dbond762/FPGA-Coursework-Sound_Level_Indicator/README.md

# Індикатор рівня звуку

Модуль визначає гучність звукового сигналу за останніми відліками й видає її у вигляді рівня від 0 до 8, придатного для керування стовпчиком світлодіодів.

## Регістри

Зсув | Назва | Доступ        | Значення
-----|-------|---------------|---------
0x00 | IN    | запис         | Вхідний відлік, [15:0], знакове число. Запис запускає один крок.
0x04 | N     | запис/читання | Розмір вікна, 1–8.
0x08 | PEAK  | читання       | Поточний пік, ціле без знака.
0x0C | LEVEL | читання       | Поточний рівень, розряди [3:0], значення 0–8.

## Архітектура

Дизайн поділено на два модулі: обчислювальне ядро і AXI4-Lite обгортку з регістрами. Ядро нічого не знає про шину, тому його можна перевірити окремо простим тестбенчем, а обгортка відповідає тільки за протокол і регістри.

### Ядро `level_indicator`

Файл `ip_repo/axi_level_indicator/level_indicator.sv`.

| Порт | Напрям | Опис |
|---|---|---|
| `clk`, `reset` | вхід | Тактовий сигнал і асинхронне скидання (активний рівень 1) |
| `in_data[15:0]` | вхід | Знаковий відлік |
| `in_valid` | вхід | Імпульс на один такт: прийняти `in_data` як новий відлік |
| `window[3:0]` | вхід | Розмір вікна N |
| `peak[15:0]` | вихід | Пік, ціле без знака |
| `level[3:0]` | вихід | Рівень 0–8 |

Як працює:

1. **Модуль на вході.** Модуль відліку обчислюється комбінаційно, у 16-бітній беззнаковій арифметиці: `in_data[15] ? (~in_data + 1) : in_data`. Для −32768 це дає `0x8000` = 32768, що вміщується в 16 біт без знака.
2. **Зсувний регістр на 8 елементів** (максимальне вікно). На кожен `in_valid` модуль нового відліку записується в `mem[0]`, решта зсувається, тож `mem[0]` завжди найновіший відлік. Усі тригери працюють від одного `clk`, а `in_valid` діє як clock enable.
3. **Маска вікна.** Маска `win_mask[7:0]` обчислюється з N і зберігається в регістрі (для N = 3 це `00000111`), а елементи поза маскою замінюються нулем. Модулі невід'ємні, тому нуль не впливає на максимум. `mem[0]` у вікні завжди, тому N = 0 поводиться як N = 1. Буфер завжди зберігає останні 8 відліків, тому при зменшенні N враховуються лише останні N, а при збільшенні старі відліки знову потрапляють у вікно.
4. **Дерево порівнянь і регістр піку.** Максимум 8 значень обчислюється комбінаційно деревом із 7 компараторів глибиною 3 (8 → 4 → 2 → 1), а результат записується в регістр `peak` на кожному такті.
5. **Рівень.** ⌈PEAK / 4096⌉ обчислюється комбінаційно від регістра `peak` як `peak[15:12] + (|peak[11:0])`: старші 4 біти плюс 1, якщо молодші 12 біт не нульові. Це те саме, що `(peak + 4095) >> 12`, але замість 17-бітного суматора потрібен 4-бітний інкремент. Оскільки `peak` ≤ `0x8000`, результат 0–8 вміщується в 4 біти.

**Затримка.** Запис відліку оновлює буфер на першому фронті, а `peak` і `level` — на наступному, тобто через один такт. Зміна N відображається через два такти: спочатку оновлюється регістр маски, потім `peak`. Процесор читає `PEAK` через кілька тактів після запису, тому цієї затримки не помічає.

**Чому пік зареєстровано.** У першій версії `peak` і `level` були повністю комбінаційними. Тоді на 100 МГц шлях `n_reg` → маска → дерево порівнянь → суматор рівня → мультиплексор читання AXI → `s_axi_rdata` мав 15 рівнів логіки і 12,6 нс при бюджеті 10 нс (WNS = −2,69 нс). Регістр `peak` розрізає цей шлях на два коротші, а спрощена формула рівня скорочує другий. Після цього залишився шлях `n_reg` → маска → дерево → `peak` (WNS = −0,85 нс), тому маску теж винесено в регістр: порівняння `i < N` більше не стоїть на початку довгого шляху.

### AXI-обгортка `axi_level_indicator`

Файл `ip_repo/axi_level_indicator/axi_level_indicator.sv`. AXI4-Lite slave з 32-бітною шиною даних і 4-бітною адресою. Порти шини мають префікс `s_axi_`, тому IP Packager у Vivado сам розпізнає інтерфейс.

- **Запис.** Канали адреси (AW) і даних (W) приймаються незалежно і в будь-якому порядку. Коли отримано обидва і канал відповіді вільний, виконується запис і видається відповідь `OKAY`.
- **IN (`0x00`).** Запис формує для ядра імпульс `in_valid` на один такт; молодші 16 біт даних ідуть у `in_data`. Тому кожен запис — це рівно один відлік, навіть якщо значення повторюється. Читання повертає 0.
- **N (`0x04`).** Записується, тільки якщо значення в діапазоні 1–8; запис іншого значення ігнорується і N зберігає попереднє значення. Після скидання N = 1.
- **PEAK (`0x08`), LEVEL (`0x0C`).** Тільки читання, значення беруться напряму з виходів ядра. Запис ігнорується.
- **Скидання.** `s_axi_aresetn` (активний рівень 0) інвертується і подається на ядро.
- **Порт `level[3:0]`** виведено назовні окремо від шини для підключення світлодіодів через XDC.

## Веріфікація

Є два тестбенчі, обидва перевіряють результат самі: кожна перевірка друкує `PASS` або `FAIL`, а в кінці виводиться `ALL TESTS PASSED` або кількість невдалих перевірок.

| Тестбенч | Що перевіряє |
|---|---|
| `coursework.srcs/sim_1/new/tb_level_indicator.sv` | Ядро `level_indicator` напряму: сценарії 1–3 і додаткові перевірки нижче |
| `coursework.srcs/sim_1/new/tb_axi_level_indicator.sv` | AXI-обгортку: ті самі сценарії 1–3 через шину. Перед кожним сценарієм скидання, запис `N` у `0x04` і читання назад. Після кожного запису в `IN` читаються `PEAK` і `LEVEL` і додатково звіряється зовнішній порт `level` |

### Як отримано очікувані значення

Очікувані значення обчислено вручну до запуску за такими правилами:

1. **Модуль відліку**: |x|. Для −32768 модуль дорівнює 32768, тобто на 1 більший за найбільше додатне значення 32767.
2. **Пік**: найбільший модуль серед останніх N відліків. Відліки, що вийшли з вікна, не враховуються.
3. **Рівень**: діапазон 0…32768 поділено на 8 рівних сходинок по 32768 / 8 = 4096. Рівень дорівнює ⌈PEAK / 4096⌉, в апаратурі це `(PEAK + 4095) >> 12`. Нульовий сигнал дає рівень 0, будь-який ненульовий — щонайменше 1, а 32767 і 32768 — рівень 8. Межі сходинок: 4096·k дає рівень k, а 4096·k + 1 — рівень k + 1.

У таблицях вікно записано від найстарішого відліку до найновішого, у вигляді модулів.

### Сценарій 1 — ковзне вікно, N = 4

Перевіряє, що старі відліки виходять із вікна і пік зменшується.

| № | IN | Вікно (модулі) | PEAK | LEVEL | Пояснення |
|---|---:|---|---:|---:|---|
| 1 | 100 | 100 | 100 | 1 | Перший відлік |
| 2 | −300 | 100, 300 | 300 | 1 | Від'ємний відлік, береться модуль |
| 3 | 50 | 100, 300, 50 | 300 | 1 | |
| 4 | 20 | 100, 300, 50, 20 | 300 | 1 | Вікно заповнене |
| 5 | 10 | 300, 50, 20, 10 | 300 | 1 | 100 вийшов з вікна |
| 6 | 5 | 50, 20, 10, 5 | 50 | 1 | 300 вийшов з вікна, пік зменшився |

### Сценарій 2 — граничні значення, N = 1

Граничний випадок: найбільше додатне значення і −32768, модуль якого не вміщується в 16-бітне знакове число.

| № | IN | Вікно (модулі) | PEAK | LEVEL | Пояснення |
|---|---:|---|---:|---:|---|
| 1 | 32767 | 32767 | 32767 | 8 | ⌈32767 / 4096⌉ = ⌈7,9998⌉ = 8 |
| 2 | −32768 | 32768 | 32768 | 8 | Модуль 32768 = `0x8000`, максимально можливий сигнал |

### Сценарій 3 — рівні та знак, N = 3

| № | IN | Вікно (модулі) | PEAK | LEVEL | Пояснення |
|---|---:|---|---:|---:|---|
| 1 | 0 | 0 | 0 | 0 | Нульовий сигнал дає рівень 0 |
| 2 | 16384 | 0, 16384 | 16384 | 4 | 16384 = 4·4096 рівно, межа сходинки |
| 3 | 32767 | 0, 16384, 32767 | 32767 | 8 | |
| 4 | 16384 | 16384, 32767, 16384 | 32767 | 8 | |
| 5 | 0 | 32767, 16384, 0 | 32767 | 8 | Вікно заповнене, 32767 ще в ньому |
| 6 | −16384 | 16384, 0, 16384 | 16384 | 4 | 32767 вийшов з вікна |
| 7 | −32768 | 0, 16384, 32768 | 32768 | 8 | |

### Додаткові перевірки ядра

Ці сценарії є тільки в тестбенчі ядра.

| Сценарій | Дії | Очікуваний результат | Пояснення |
|---|---|---|---|
| Межі рівнів (N = 1) | Відліки 0, 1, 4096·k і 4096·k + 1 для k = 1…7, 32767, −32768, −1, −4097, −28673 | 0 → 0; 4096·k → k; 4096·k + 1 → k + 1; 32767 і −32768 → 8; −1 → 1; −4097 → 2; −28673 → 8 | Обидві сторони кожної межі сходинки |
| Помилкове N = 0 | N = 0, відліки 100, 200 | PEAK = 100, потім 200; LEVEL = 1 | Помилковий випадок: ядро трактує N = 0 як N = 1 (наймолодший відлік завжди у вікні) |
| N = 1 | N = 1, відліки 100, 200 | PEAK = 100, потім 200; LEVEL = 1 | Пік дорівнює останньому відліку |
| Зміна N | N = 8, відліки 30000 і 7 × 10; потім N = 3 і N = 8 без нових записів | Після записів PEAK = 30000, LEVEL = 8; при N = 3 PEAK = 10, LEVEL = 1; при N = 8 знову PEAK = 30000, LEVEL = 8 | При зменшенні N враховуються тільки останні N відліків, старі значення в буфері не губляться |
| Повторний запис | N = 2, відліки 500, 100, 100 | PEAK = 500, 500, 100 | Два однакові відліки — це два окремі кроки |
| Без запису | N = 1, відлік 200, далі `in_data` = 30000 три такти при `in_valid` = 0 | PEAK = 200, LEVEL = 1 | Без імпульсу запису буфер не змінюється |

### Перевірка тестбенчів на модулі з помилкою

Щоб показати, що тестбенчі справді щось перевіряють, є копія ядра з навмисною помилкою: `coursework.srcs/sim_1/new/level_indicator_bug.sv`. Модуль у ній має ту саму назву `level_indicator`, тому в проєкті одночасно вмикається тільки один із двох файлів. Копію додано в проєкт як design source (як і оригінал), а перемикання робиться в Sources: правою кнопкою → Disable File / Enable File. Після перевірки оригінал вмикається назад, а копія вимикається. Під час запуску копія друкує `*** BUGGY level_indicator (registered abs_in) ***`.

**Помилка.** Модуль відліку `abs_in` зроблено регістром і записано неблокуючим присвоюванням у тому самому такті, що й зсув буфера:

```systemverilog
abs_in <= in_data[15] ? (~in_data + 16'd1) : in_data;
mem    <= {mem[6:0], abs_in};   // у буфер іде старе abs_in
```

Обидва присвоювання неблокуючі, тому в буфер потрапляє модуль **попереднього** відліку: буфер відстає від входу на один запис, а після скидання першим у буфер іде 0. Саме цю помилку було допущено в першій версії ядра.

**Очікувані провали в сценаріях 1–3.** Для моделі з помилкою вміст буфера зсунуто на один відлік. Перевірка падає там, де через це змінюється PEAK або LEVEL.

| Сценарій | № | IN | Очікувано PEAK / LEVEL | З помилкою PEAK / LEVEL | Результат |
|---|---|---:|---|---|---|
| 1 (N = 4) | 1 | 100 | 100 / 1 | 0 / 0 | FAIL |
| | 2 | −300 | 300 / 1 | 100 / 1 | FAIL |
| | 3–5 | 50, 20, 10 | 300 / 1 | 300 / 1 | PASS |
| | 6 | 5 | 50 / 1 | 300 / 1 | FAIL |
| 2 (N = 1) | 1 | 32767 | 32767 / 8 | 0 / 0 | FAIL |
| | 2 | −32768 | 32768 / 8 | 32767 / 8 | FAIL |
| 3 (N = 3) | 1 | 0 | 0 / 0 | 0 / 0 | PASS |
| | 2 | 16384 | 16384 / 4 | 0 / 0 | FAIL |
| | 3 | 32767 | 32767 / 8 | 16384 / 4 | FAIL |
| | 4–5 | 16384, 0 | 32767 / 8 | 32767 / 8 | PASS |
| | 6 | −16384 | 16384 / 4 | 32767 / 8 | FAIL |
| | 7 | −32768 | 32768 / 8 | 16384 / 4 | FAIL |

Частина кроків проходить, бо при широкому вікні зсув на один відлік не змінює максимум. Тому важливі сценарії з N = 1 і з виходом піку з вікна: на них помилка видна на кожному кроці.

**Очікуваний підсумок:**

- `tb_axi_level_indicator`: 9 із 15 перевірок відліків падають (3 + 2 + 4), у кінці `9 CHECK(S) FAILED`. Читання N назад проходить, бо регістр N у обгортці не залежить від помилки.
- `tb_level_indicator`: 38 із 55 перевірок падають, у кінці `38 CHECK(S) FAILED`. Окрім сценаріїв 1–3, падають майже всі межі рівнів (20 із 21, проходить тільки перший відлік 0), N = 0 і N = 1, повторний запис і перевірка без запису (там пік 0 замість 200, бо 200 ще не дійшло до буфера). У зміні N падає тільки перший запис, а перевірки при N = 3 і N = 8 проходять: після восьми записів зсув на один відлік уже не впливає.

### Результати

Усі перевірки в обох тестбенчах пройшли (`ALL TESTS PASSED`).

**Рис. 1.** Тестбенч ядра `tb_level_indicator`

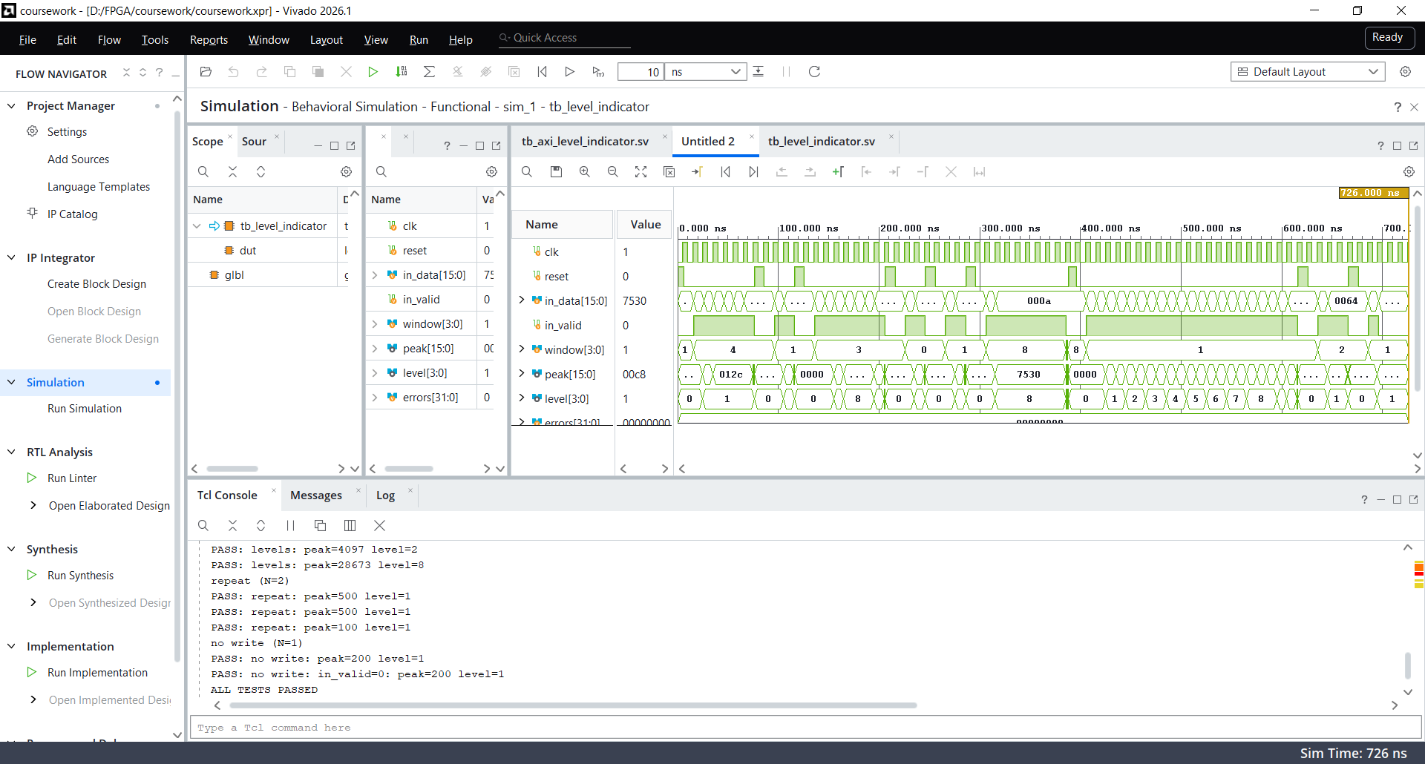
[picture p1: docs/Figure 1 - Core Testbench.png]
Рис. 1 - Тестбенч ядра


**Рис. 2.** Тестбенч AXI-обгортки `tb_axi_level_indicator`

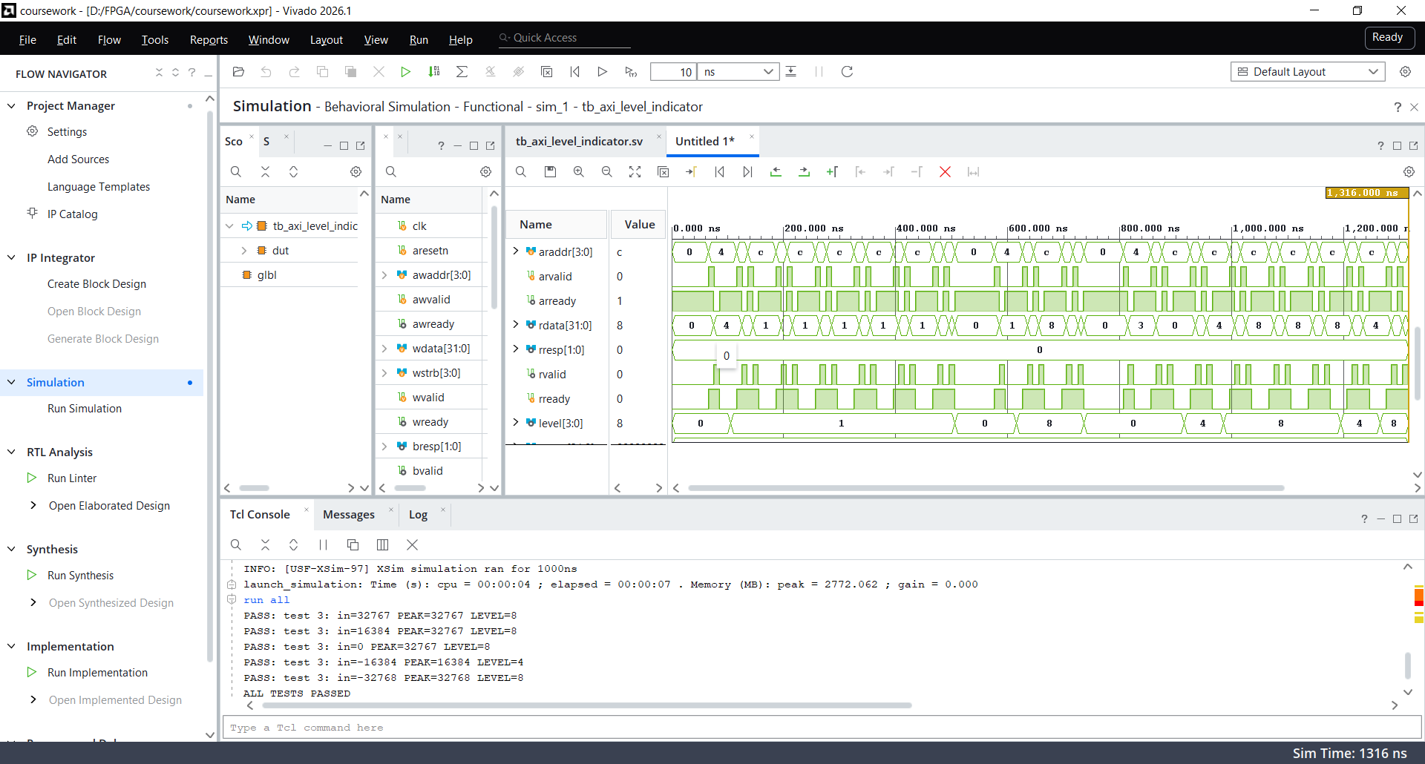
[picture p2: docs/Figure 2 - AXI wrapper Testbench.png]
Рис. 2 - Тестбенч AXI обгортки


**Перевірка на модулі з помилкою.** Результати збіглися з передбаченими: `tb_level_indicator` завершився з `38 CHECK(S) FAILED`, `tb_axi_level_indicator` — з `9 CHECK(S) FAILED`. Отже, тестбенчі виявляють помилку в ядрі.

**Рис. 3.** Тестбенч ядра `tb_level_indicator` на модулі з помилкою

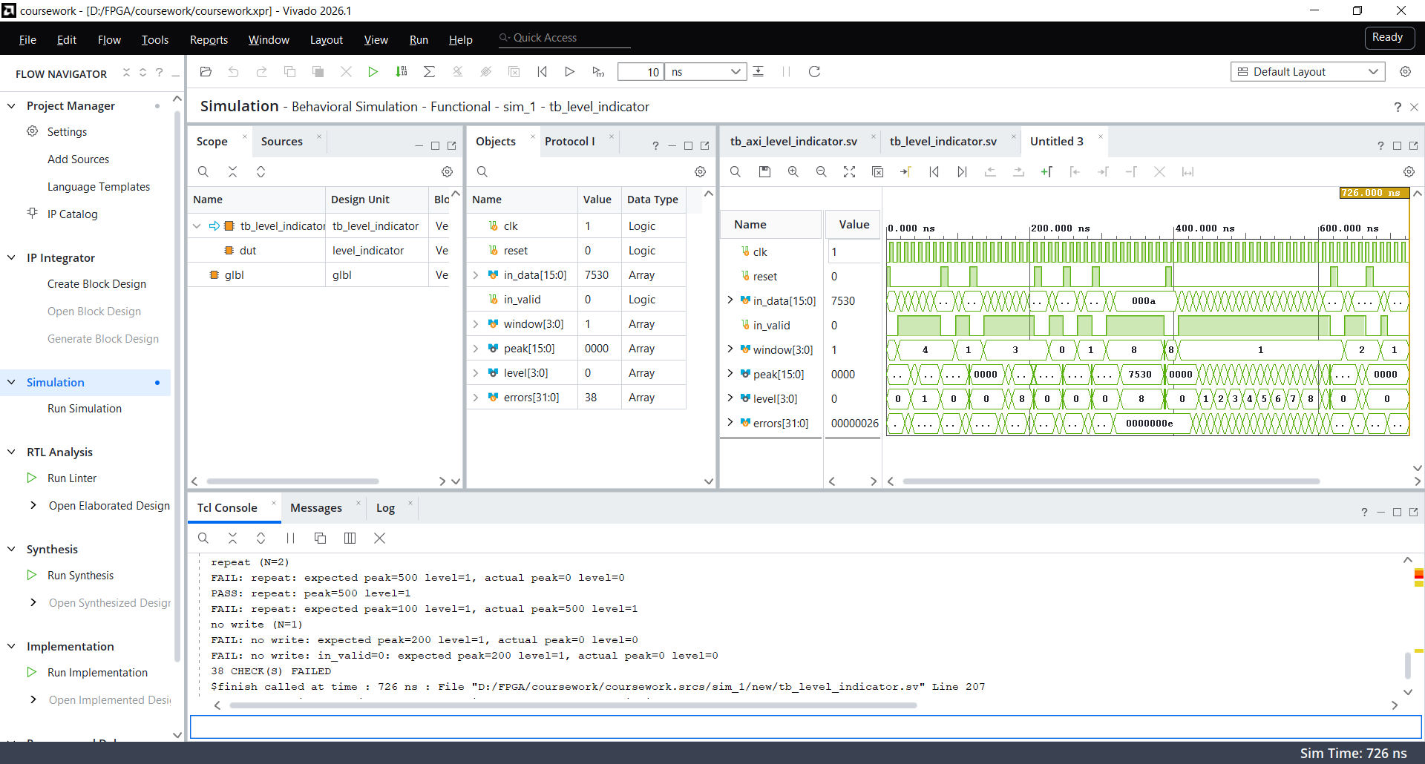
[picture p3: docs/Figure 3 - Core Testbench with bug.png]
Рис. 3 - Тестбенч ядра з помилкою


**Рис. 4.** Тестбенч AXI-обгортки `tb_axi_level_indicator` на модулі з помилкою

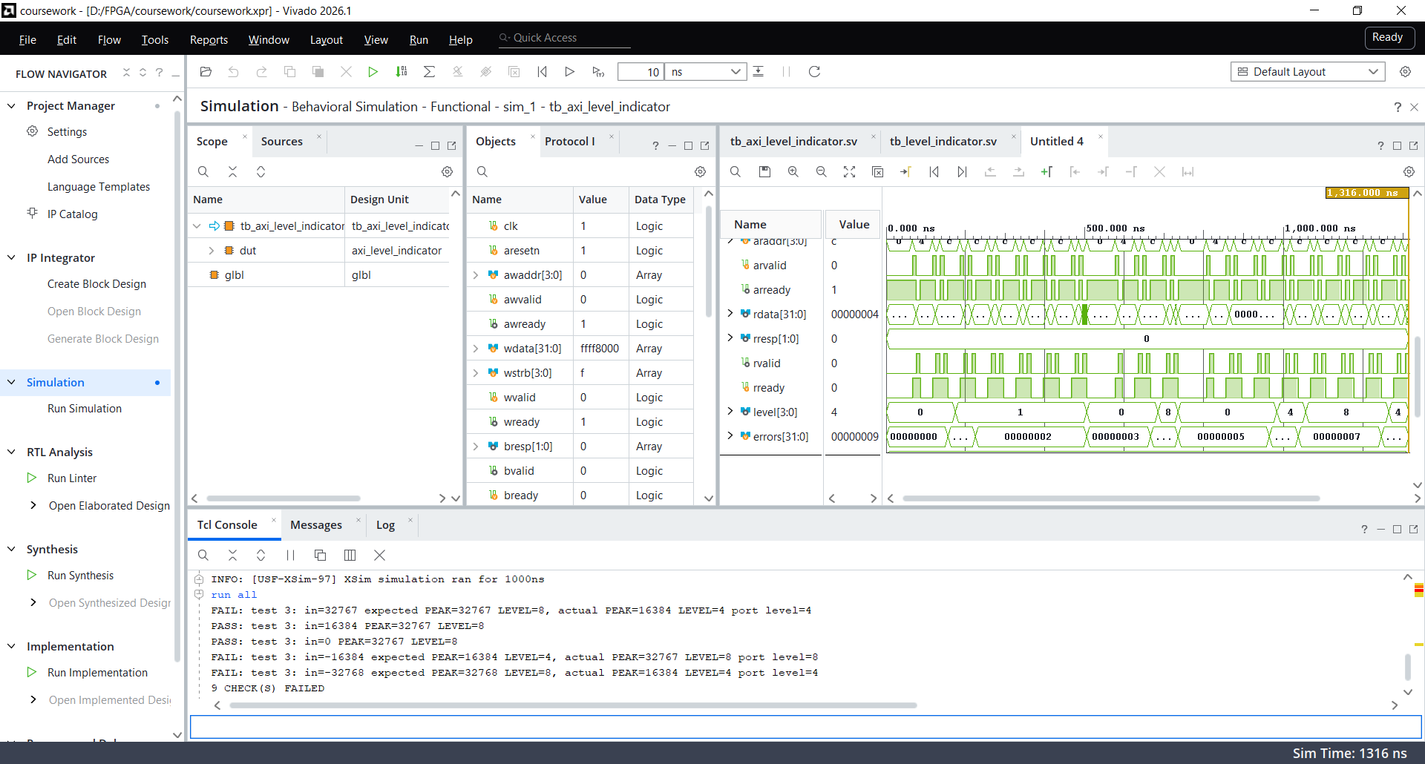
[picture p4: docs/Figure 4 - AXI wrapper Testbench with bug.png]
Рис. 4 - Тестбенч AXI обгортки з помилкою


## IP Catalog

Модуль було упаковано в IP block та додано в IP Catalog (Рис. 5).

**Рис. 5.** Модуль AXI Level Indicator в IP Catalog

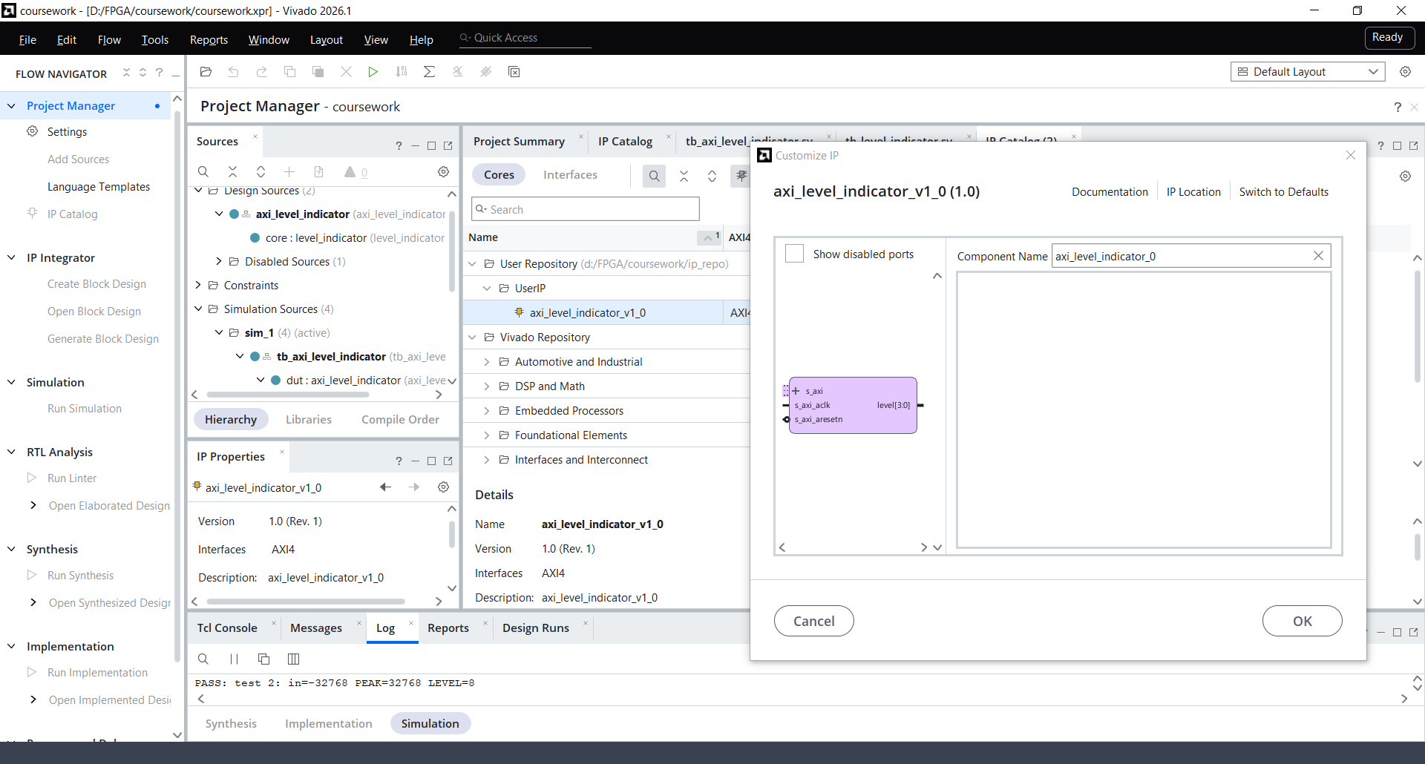
[picture p5: docs/Figure 5 - AXI Level Indicator in IP Catalog.png]
Рис. 5 - Модуль AXI Level Indicator в IP Catalog


## Block Design

Система будується на базі MicroBlaze процесора, до якого по AXI шині під'єднаний наш IP block AXI Level Indicator.

**Рис. 6.** Block Design

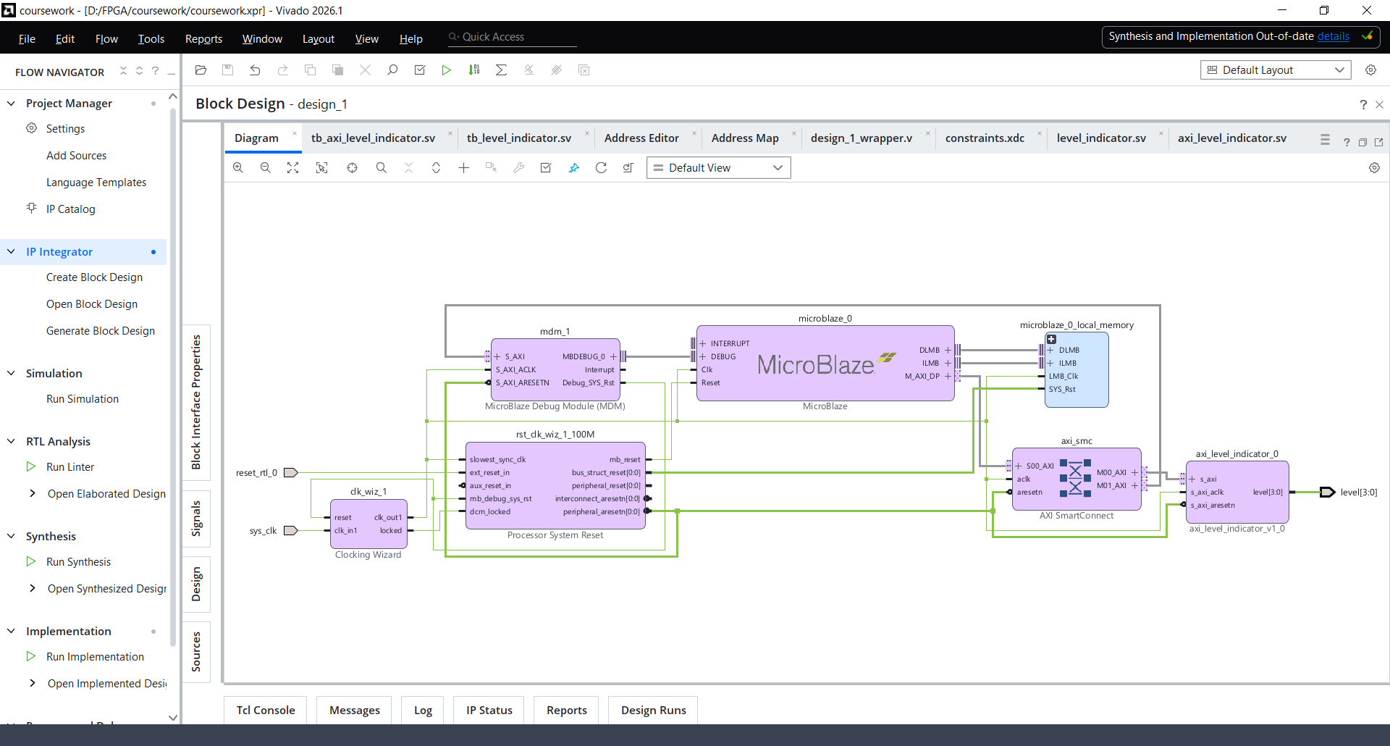
[picture p6: docs/Figure 6 - Block Design.png]
Рис. 6 - Block Design


**Рис. 7.** Address Editor

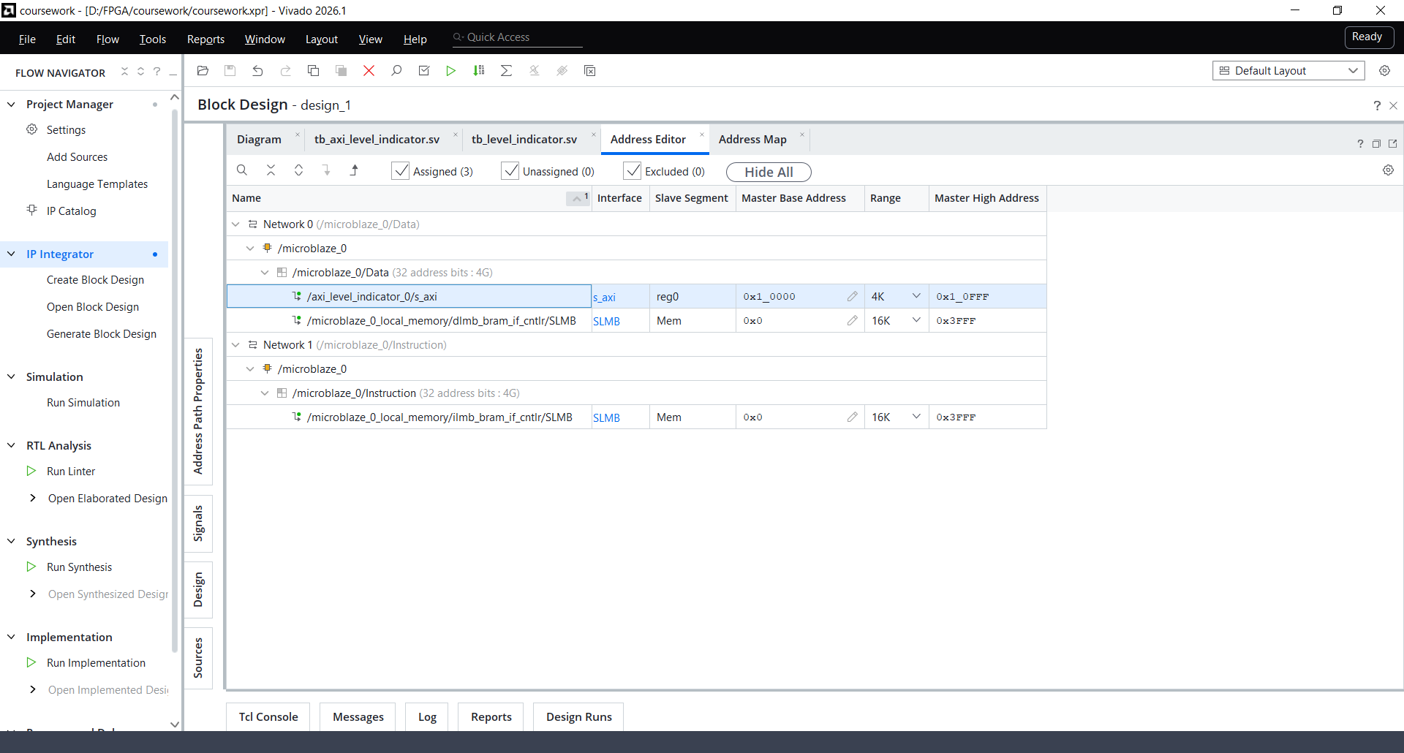
[picture p7: docs/Figure 7 - Address Editor.png]
Рис. 7 - Address Editor


**Рис. 8.** Block Design Validation

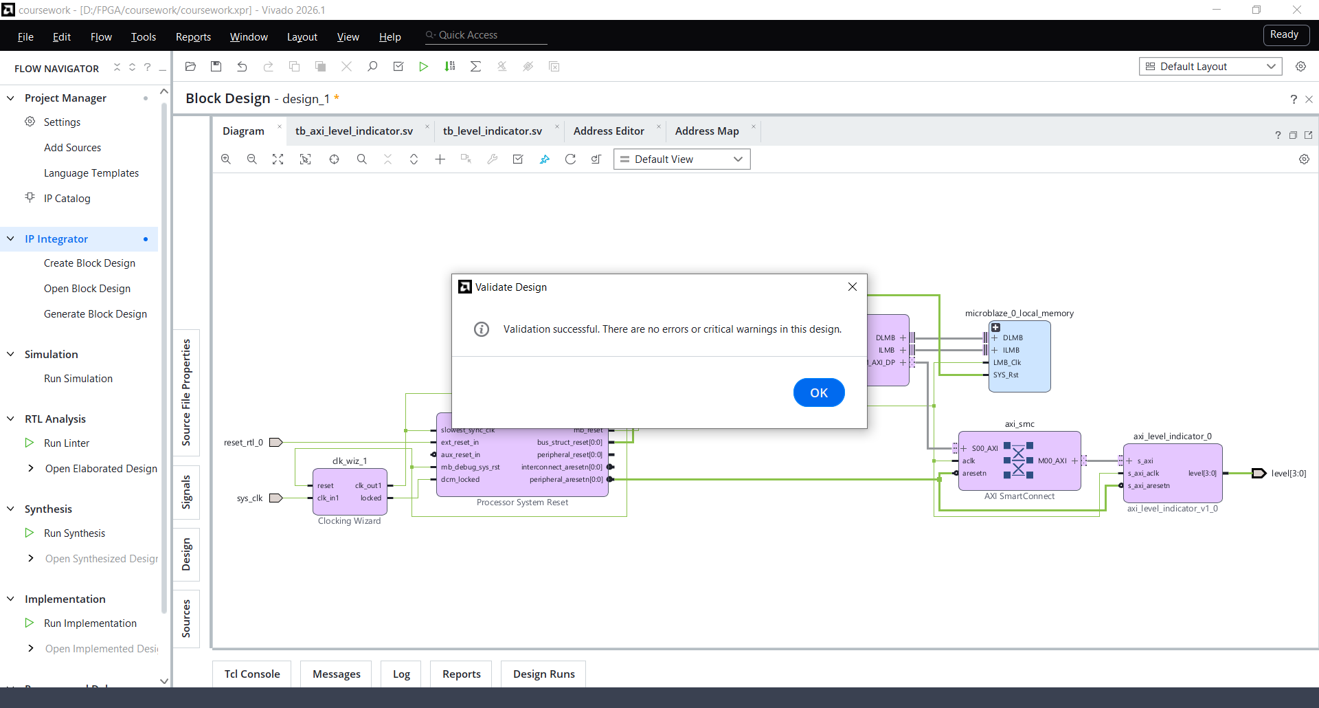
[picture p8: docs/Figure 8 - Validation Successful.png]
Рис. 8 - Block Design Validation


## Системна симуляція

Тестбенч верхнього рівня `coursework.srcs/sim_1/new/tb_design.v` запускає всю систему: `design_1_wrapper` з MicroBlaze, який виконує програму з `app_component` (ELF прив'язаний до `microblaze_0` для симуляції). Тестбенч подає клок 125 МГц, як на PYNQ-Z2, знімає скидання і дає системі пропрацювати 200 мкс. Автоматичних перевірок у ньому немає: роботу системи видно на вейвформах.

Для симуляції програму зібрано з визначенням `SIMULATION`: у ній немає затримок `usleep` і виводу `xil_printf`. JTAG UART у симуляції ніхто не читає, тому без цього програма зупинилася б на першому виводі.

На Рис. 9 показано запис відліку −32768 (дев'ятий відлік програми, N = 4):

1. Процесор виконує запис по AXI в регістр `IN` (`s_axi_awvalid`, `s_axi_wvalid`, `s_axi_wdata` = −32768), після чого обгортка видає відповідь `s_axi_bvalid`.
2. Обгортка формує для ядра імпульс `in_valid` на один такт, `in_data` = −32768.
3. На наступному фронті модуль 32768 записується в буфер `mem`.
4. Ще через такт оновлюється регістр піку: `peak` змінюється з 27000 на 32768, а `level` — з 7 на 8.

`n_reg` = 4 і `win_mask` = `0x0F` підтверджують, що програма встановила розмір вікна 4.

**Рис. 9.** Симуляція всієї системи (`tb_design`)

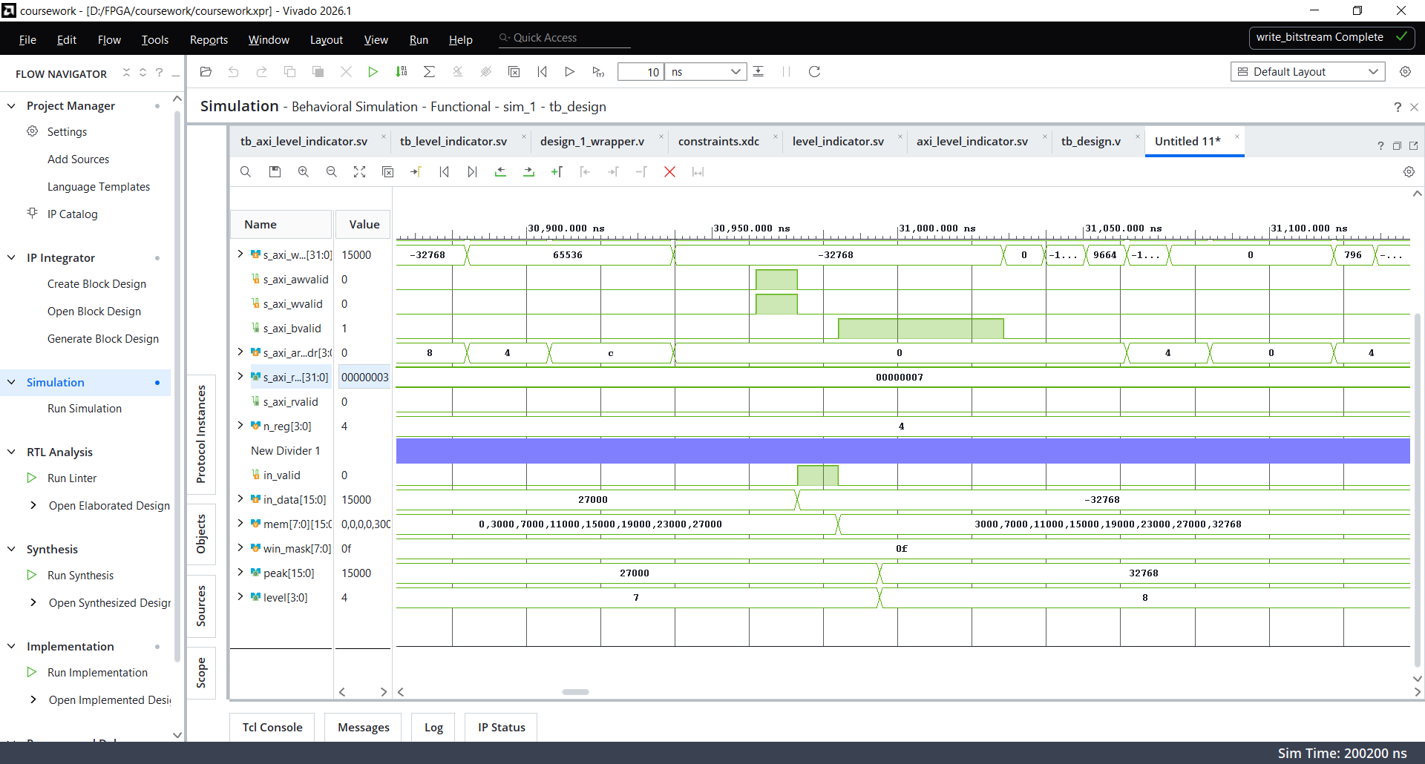
[picture p9: docs/Figure 9 - Top Level Testbench.png]
Рис. 9 - Симуляція всієї системи


## Ресурси та таймінги

Звіти після імплементації для `xc7z020clg400-1` (PYNQ-Z2).

| Ресурс | Використано | Доступно | % |
|---|---:|---:|---:|
| Slice LUTs | 1538 | 53200 | 2,89 |
| Slice Registers | 1396 | 106400 | 1,31 |
| Block RAM Tile | 4 | 140 | 2,86 |
| DSPs | 0 | 220 | 0 |
| Bonded IOB | 6 | 125 | 4,80 |
| MMCME2_ADV | 1 | 4 | 25 |

**Рис. 10.** Звіт про використання ресурсів (Report Utilization)

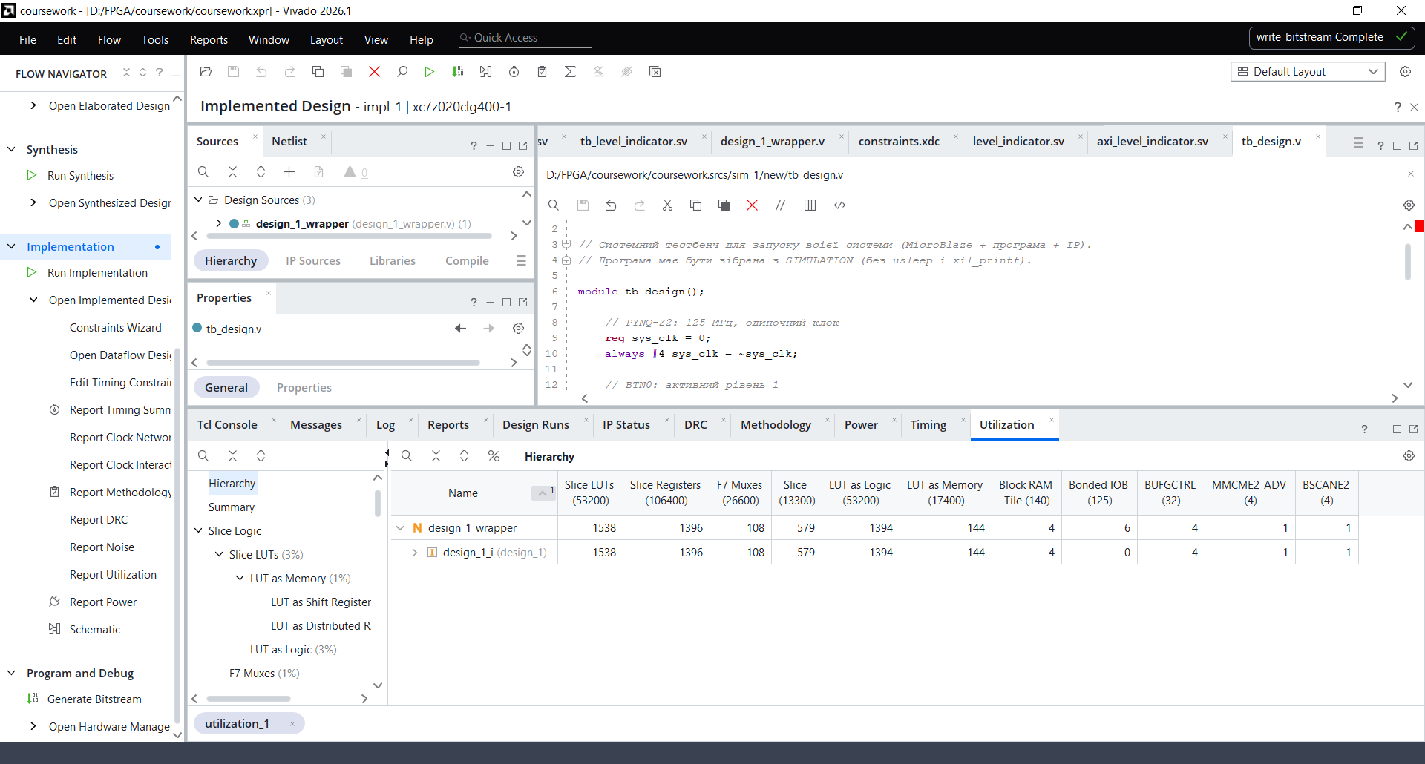
[picture p10: docs/Figure 10 - Report Utilization.png]
Рис. 10 - Звіт про використання ресурсів


**Чи вкладається проєкт у час.** Так: на частоті 90 МГц (період 11,111 нс) WNS = +0,349 нс і WHS = +0,018 нс, кількість кінцевих точок з порушеннями (Failing Endpoints) 0, тобто всі обмеження setup і hold виконані. Критичний шлях — від буфера `mem` через дерево порівнянь до регістра `peak`, приблизно 10,6 нс. На 100 МГц він не вкладався навіть після того, як пік і маску вікна винесено в регістри (WNS = −0,18 нс), тому частоту системи знижено до 90 МГц.

**Рис. 11.** Звіт про таймінги (Design Timing Summary)

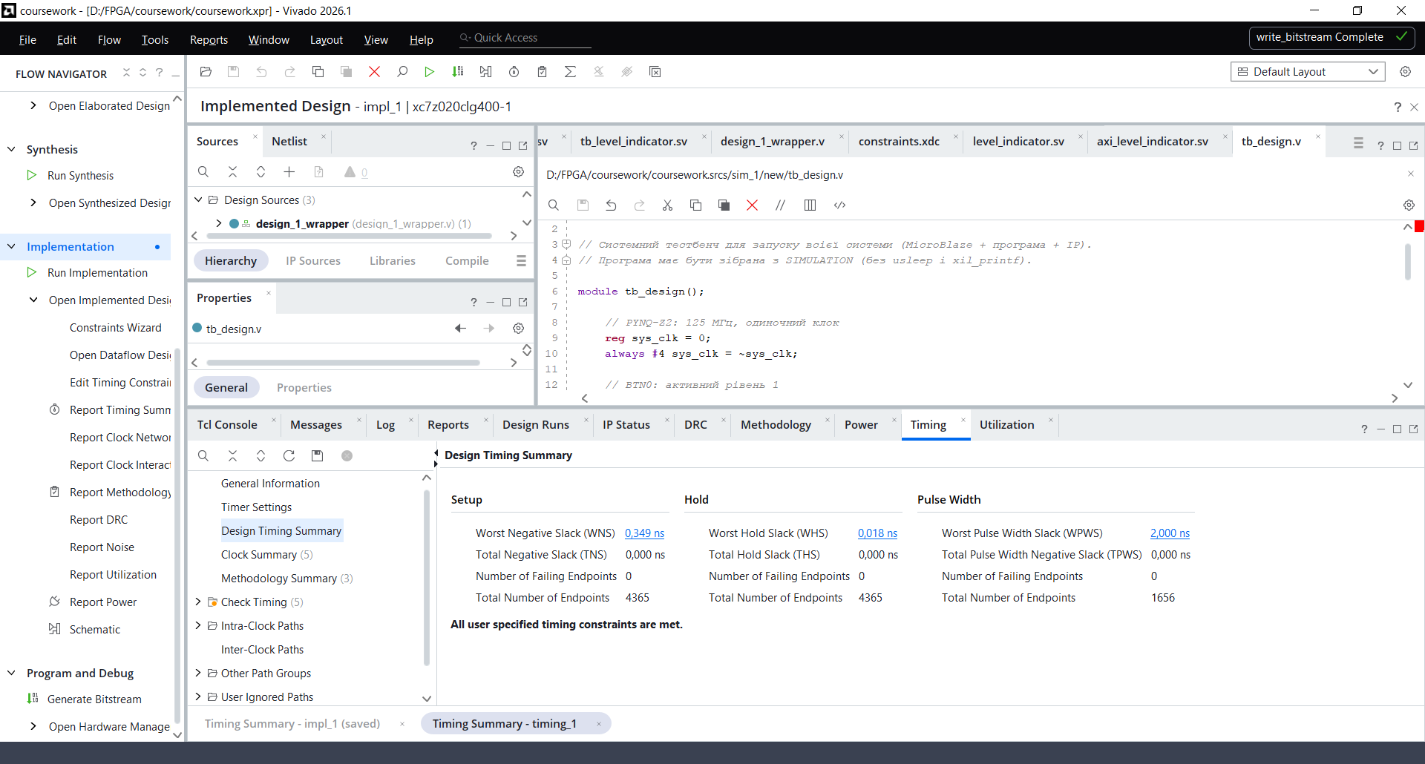
[picture p11: docs/Figure 11 - Timing Report.png]
Рис. 11 - Звіт про таймінги


## Проблеми та їх розв'язання

1. **Відлік потрапляв у буфер із запізненням на один запис.** У першій версії ядра модуль відліку `abs_in` був регістром і записувався неблокуючим присвоюванням у тому самому такті, що й зсув буфера, тому в `mem` потрапляло старе значення. Модуль зроблено комбінаційним (`wire`). Саме цю помилку згодом використано для копії ядра з навмисною помилкою, на якій тестбенчі падають.
2. **У тестбенчі ядра пік був `x` протягом перших N записів.** `in_valid` весь час тримався в 1, тому на другому фронті після скидання в буфер записувався невизначений `in_data` (а в наступних тестах — останній відлік попереднього тесту). Тепер `in_valid` — імпульс на один такт на кожен запис, як в AXI-обгортці, а на початку тесту `in_valid` і `in_data` задаються нулем.
3. **IP Packager не розбирав файли.** Ядро й обгортка використовують SystemVerilog (`always_ff`, упаковані масиви), але мали розширення `.v`, тому пакувальник читав їх як Verilog і видавав `Syntax error near '@'`. Файли перейменовано на `.sv`.
4. **Проєкт не вкладався в таймінг (WNS = −2,69 нс на 100 МГц).** Увесь шлях `n_reg` → маска → дерево порівнянь → суматор рівня → мультиплексор читання AXI був комбінаційним (15 рівнів логіки, 12,6 нс). Пік винесено в регістр, формулу рівня спрощено до `peak[15:12] + (|peak[11:0])`, маску вікна теж зроблено регістром, а частоту знижено до 90 МГц. Окремо з'ясувалося, що після зміни ядра Block Design далі використовував стару копію IP: її оновлено, збільшивши ревізію IP командами `ipx::*`, з наступним `upgrade_ip` і перегенерацією output products. Через інтерфейс це зробити не вдалося, бо Edit in IP Packager на Windows падав з `Spawn failed`.
5. **Програма для MicroBlaze не збиралася** Порожній `UserConfig.cmake` давав помилку CMake про відсутній шаблон скрипта лінковщика; файл відновлено з `USER_LINKER_SCRIPT`, що вказує на `lscript.ld`. Для симуляції програму зібрано з `SIMULATION` без `usleep` і `xil_printf`.
